NI2O/AISdecoder/AIS Mk2/aismk2-beta.jpg

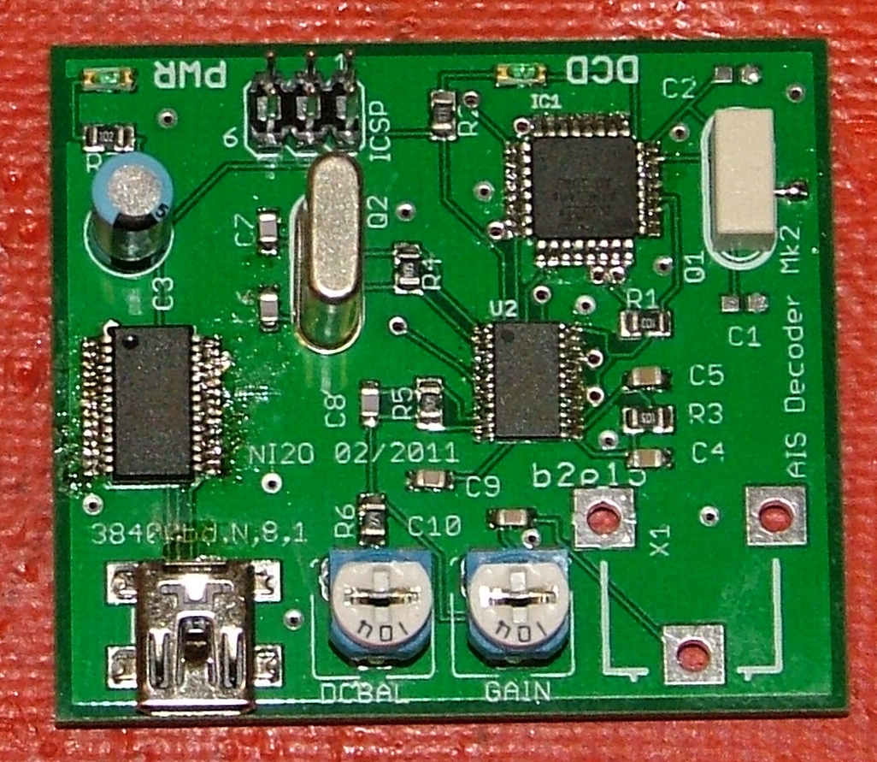
AIS Mk2/aismk2-beta.jpg
