NI2O/AISdecoder/AIS Mk2/aismk2-beta2.jpg

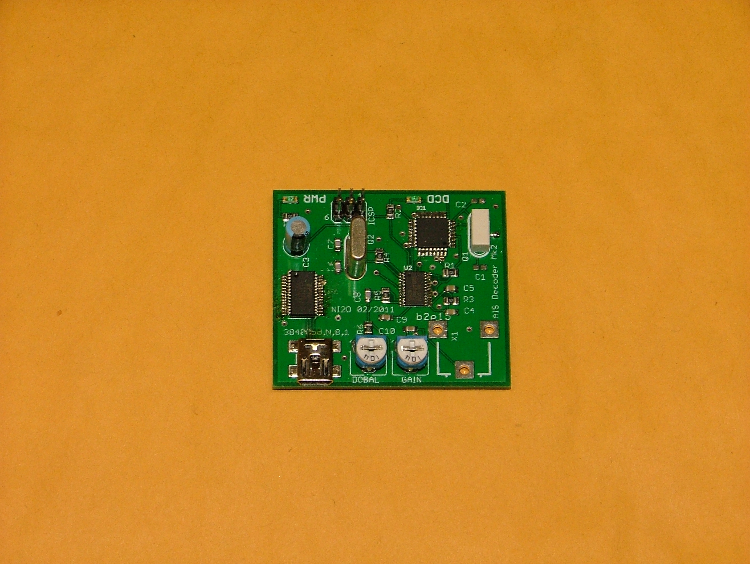
AIS Mk2/aismk2-beta2.jpg
