NI2O/AISdecoder/AIS Mk2/aismk2-render.jpg

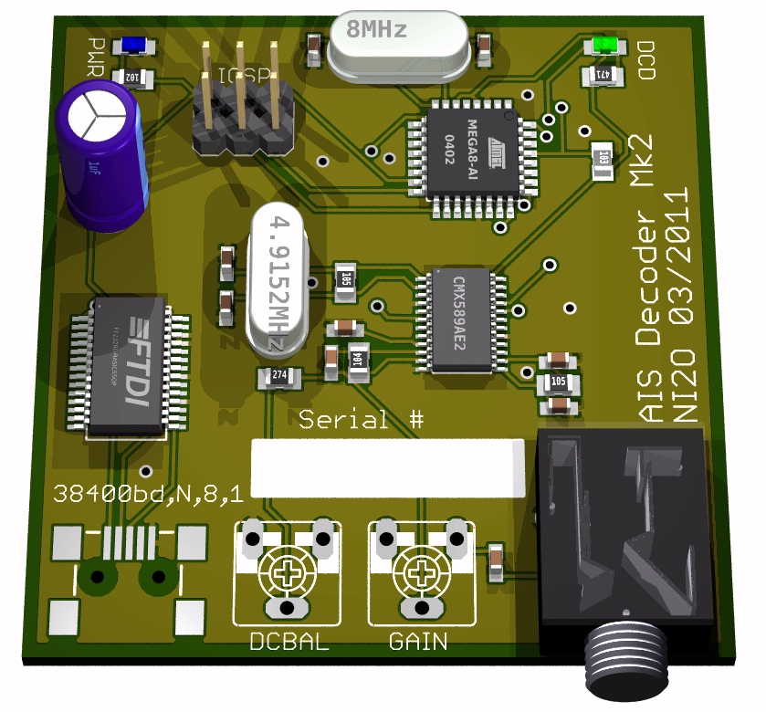
AIS Mk2/aismk2-render.jpg
