NI2O/AISdecoder/AIS Mk2/board.png

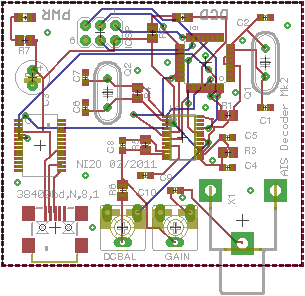
AIS Mk2/board.png
