NI2O/AISdecoder/AIS Mk2/AIS_Mk2.pdf

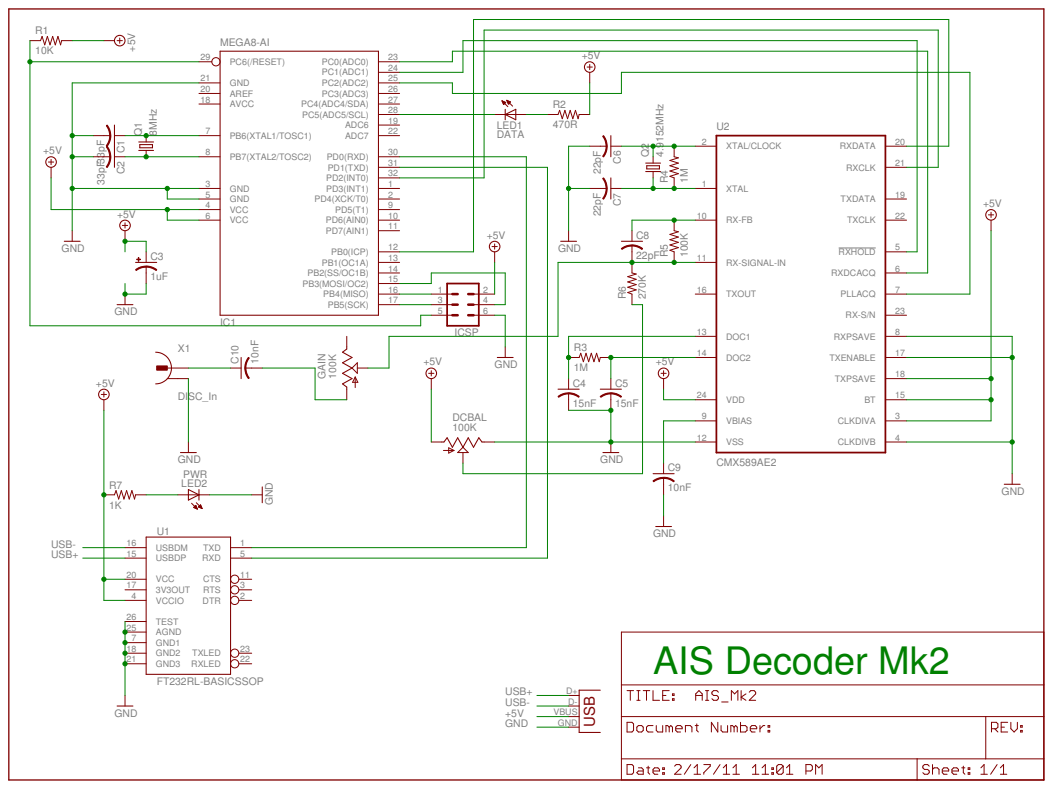
[picture p5: page 1]

22 ADC6 | | LED1

20 TXDATA 21 RXDATA

22 RXCLK 19

18 TXENABLE
