NI2O/AISdecoder/AIS Mk2/AIS_Mk2.2-board.pdf

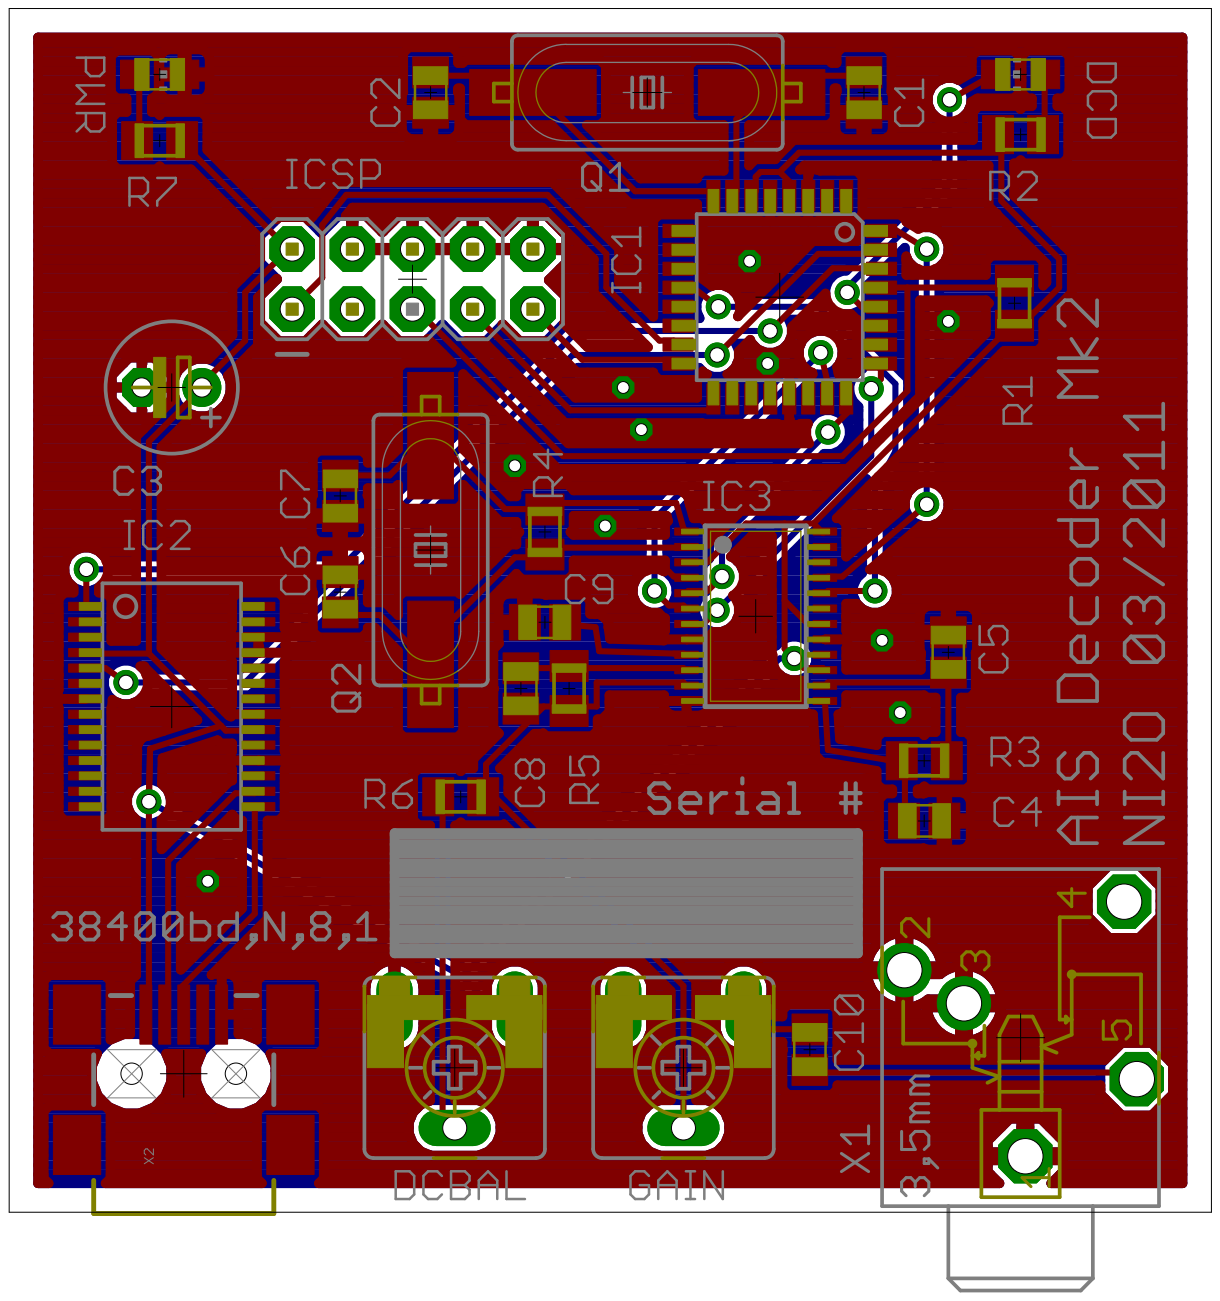
[picture p6: page 1]
