NI2O/AISdecoder/AIS Mk2/AIS_Mk2.2.pdf

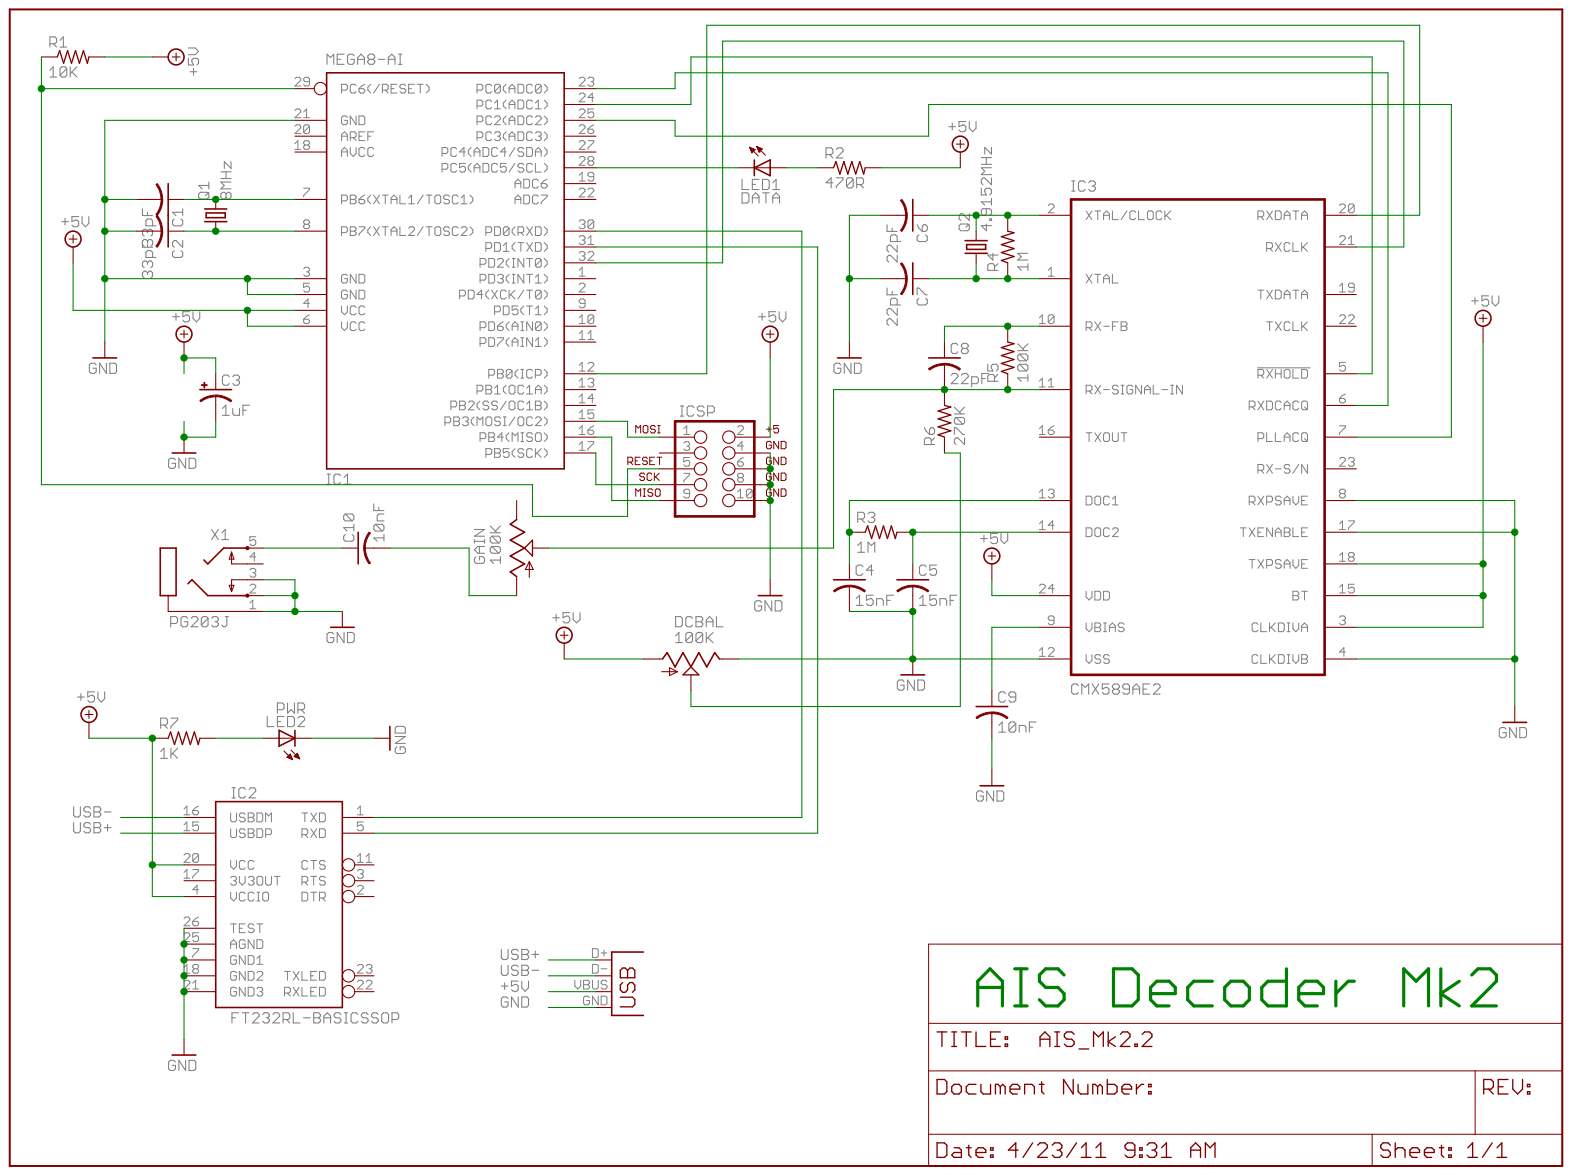
[picture p7: page 1]
