NI2O/AISdecoder/AIS Mk2/AIS_Mk2.2.brd

## EAGLE design AIS Mk2/AIS_Mk2.2.brd (2013-02-20)

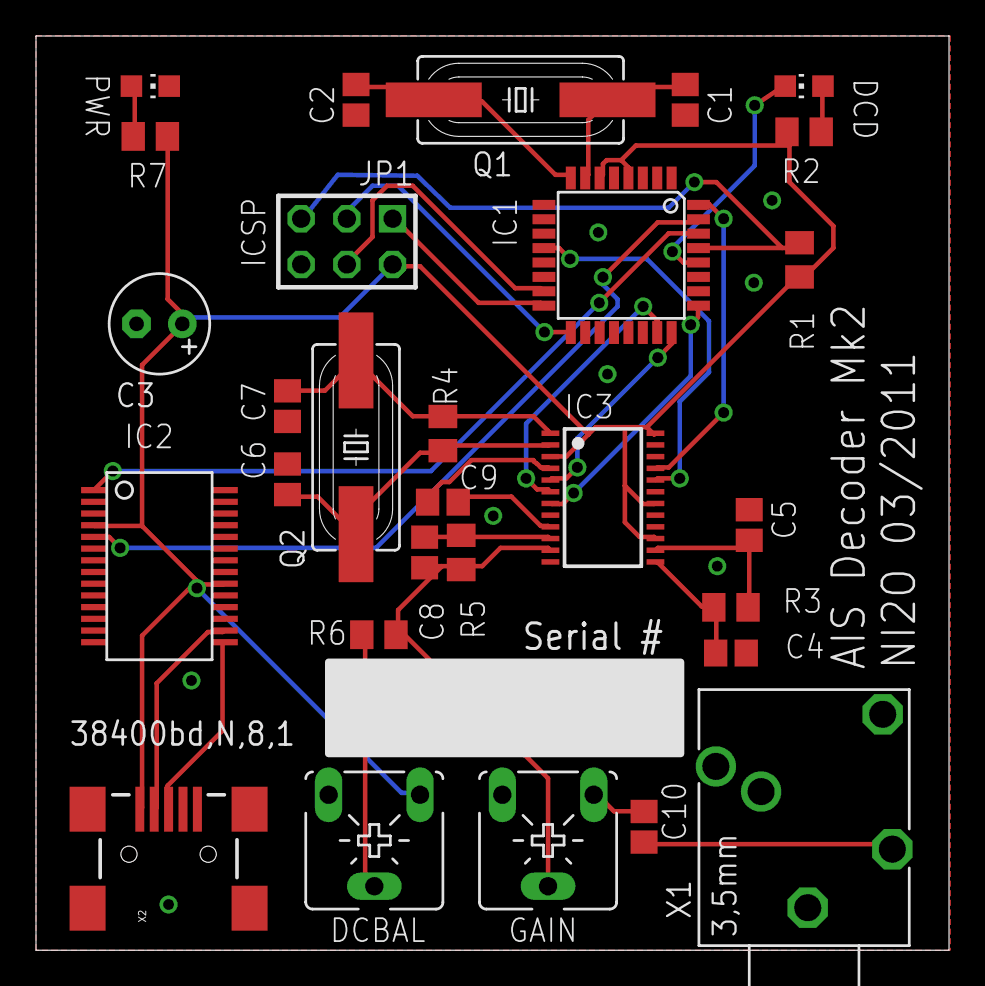
[picture p8: board AIS_Mk2.2.brd from above]

Board: 2 copper layers, 50.7 x 50.8 mm, 29 parts (0 on the bottom side), 30 nets.

Parts:
C1, C2: 33pF; C0805
C3: 1uF; E2,5-6
C4, C5: 15nF; C0805
C6, C7, C8: 22pF; C0805
C9, C10: 10nF; C0805
DCBAL: 100K; CA6V
GAIN: 100K; CA6V
IC1: MEGA8-AI; TQFP32-08
IC2: FT232RL-BASICSSOP; SSOP28DB
IC3: CMX589AE2; TSSOP24
JP1: AVR-ISP-6
LED1: DATA; CHIP-LED0805
LED2: PWR; CHIP-LED0805
Q1: 8MHz; HC49UP
Q2: 4.9152MHz; HC49UP
R1: 10K; M0805
R2: 470R; M0805
R3, R4: 1M; M0805
R5: 100K; M0805
R6: 270K; M0805
R7: 1K; M0805
X1: PG203J
X2: USBSMD; USB-MINIB

Connections:
+5V: C3.+, DCBAL.A, IC1.4, IC1.6, IC2.4, IC2.20, IC3.3, IC3.15, IC3.18, IC3.24, JP1.2, R1.2, R2.2, R7.1, X2.VBUS
DCBAL: DCBAL.S, R6.1
GND: C1.2, C2.2, C3.-, C4.2, C5.2, C6.2, C7.2, C9.2, DCBAL.E, IC1.3, IC1.5, IC1.21, IC2.7, IC2.18, IC2.21, IC2.25, IC2.26, IC3.4, IC3.8, IC3.12, IC3.17, JP1.6, LED2.C, X1.1, X1.2, X1.3, X2.GND
unnamed: C2.1, IC1.8, Q1.1
unnamed: C1.1, IC1.7, Q1.2
unnamed: IC1.17, JP1.3
unnamed: IC1.16, JP1.1
unnamed: IC1.29, JP1.5, R1.1
unnamed: C4.1, IC3.13, R3.1
unnamed: IC1.28, LED1.C
unnamed: LED1.A, R2.1
unnamed: C5.1, IC3.14, R3.2
unnamed: IC1.30, IC2.1
unnamed: IC1.31, IC2.5
unnamed: C7.1, IC3.1, Q2.1, R4.1
unnamed: C6.1, IC3.2, Q2.2, R4.2
unnamed: C8.1, IC3.10, R5.2
unnamed: C10.2, GAIN.A
unnamed: C10.1, X1.5
unnamed: C9.1, IC3.9
unnamed: IC1.32, IC3.21
unnamed: IC1.12, IC3.20
unnamed: IC1.24, IC3.5
unnamed: IC1.23, IC3.6
unnamed: IC1.25, IC3.7
unnamed: LED2.A, R7.2
unnamed: IC1.15, JP1.4
SIG: C8.2, GAIN.S, IC3.11, R5.1, R6.2
USB+: IC2.15, X2.D+
USB-: IC2.16, X2.D-
